akulladdha/riscv-32i-processor/docs/gtkwave.png

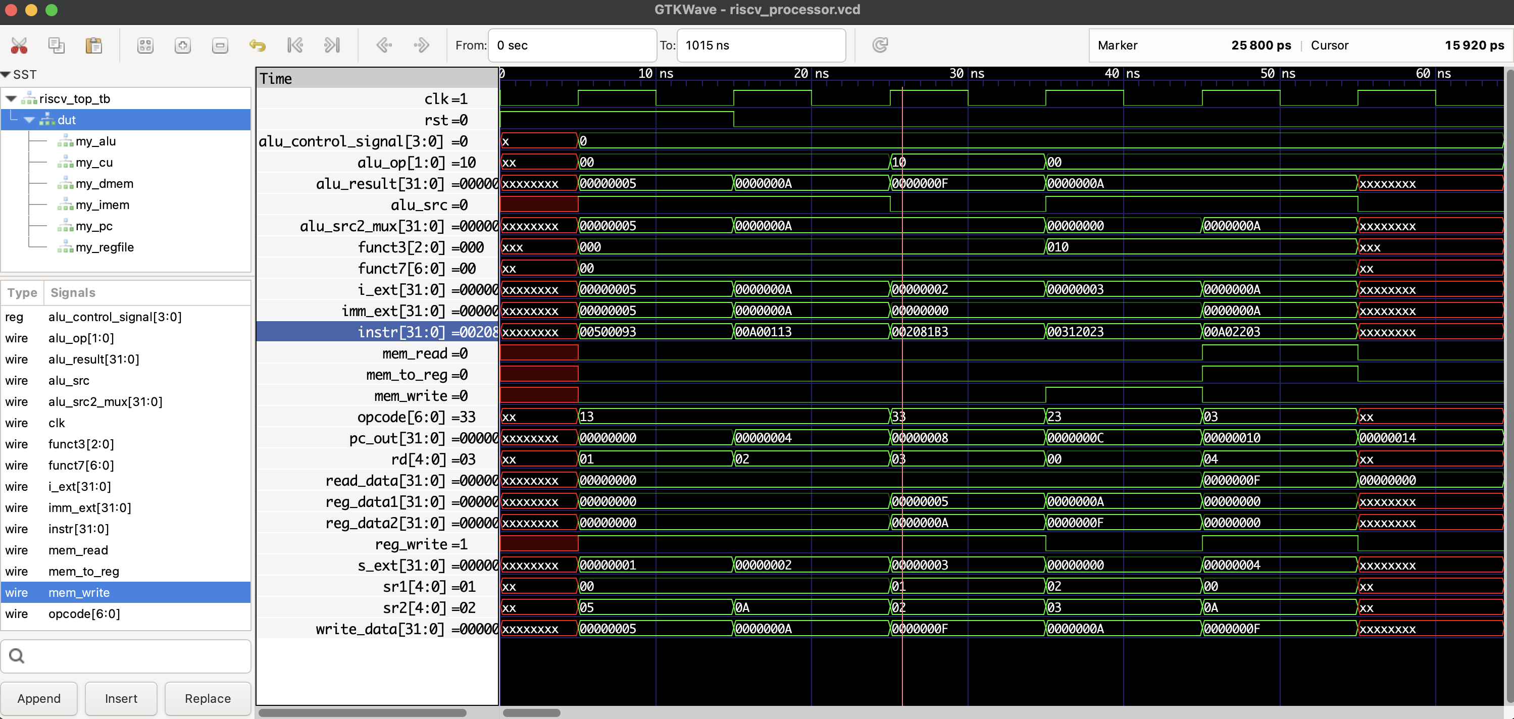
docs/gtkwave.png
