akulladdha/riscv-32i-processor/fpga/basys3.xdc

## Basys 3 constraints for basys3_top.
## Pins taken from Digilent's official Basys-3-Master.xdc, not from memory.

## ---- Clock ----
## create_clock is what makes timing analysis run at all. Without it Vivado
## checks nothing, and a design that "works" may fail after the next rebuild.
set_property -dict { PACKAGE_PIN W5   IOSTANDARD LVCMOS33 } [get_ports clk]
create_clock -add -name sys_clk_pin -period 10.00 -waveform {0 5} [get_ports clk]

## ---- Switches ----
set_property -dict { PACKAGE_PIN V17  IOSTANDARD LVCMOS33 } [get_ports {sw[0]}]
set_property -dict { PACKAGE_PIN V16  IOSTANDARD LVCMOS33 } [get_ports {sw[1]}]
set_property -dict { PACKAGE_PIN W16  IOSTANDARD LVCMOS33 } [get_ports {sw[2]}]
set_property -dict { PACKAGE_PIN W17  IOSTANDARD LVCMOS33 } [get_ports {sw[3]}]
set_property -dict { PACKAGE_PIN W15  IOSTANDARD LVCMOS33 } [get_ports {sw[4]}]
set_property -dict { PACKAGE_PIN V15  IOSTANDARD LVCMOS33 } [get_ports {sw[5]}]
set_property -dict { PACKAGE_PIN W14  IOSTANDARD LVCMOS33 } [get_ports {sw[6]}]
set_property -dict { PACKAGE_PIN W13  IOSTANDARD LVCMOS33 } [get_ports {sw[7]}]
set_property -dict { PACKAGE_PIN V2   IOSTANDARD LVCMOS33 } [get_ports {sw[8]}]
set_property -dict { PACKAGE_PIN T3   IOSTANDARD LVCMOS33 } [get_ports {sw[9]}]
set_property -dict { PACKAGE_PIN T2   IOSTANDARD LVCMOS33 } [get_ports {sw[10]}]
set_property -dict { PACKAGE_PIN R3   IOSTANDARD LVCMOS33 } [get_ports {sw[11]}]
set_property -dict { PACKAGE_PIN W2   IOSTANDARD LVCMOS33 } [get_ports {sw[12]}]
set_property -dict { PACKAGE_PIN U1   IOSTANDARD LVCMOS33 } [get_ports {sw[13]}]
set_property -dict { PACKAGE_PIN T1   IOSTANDARD LVCMOS33 } [get_ports {sw[14]}]
set_property -dict { PACKAGE_PIN R2   IOSTANDARD LVCMOS33 } [get_ports {sw[15]}]

## ---- LEDs ----
set_property -dict { PACKAGE_PIN U16  IOSTANDARD LVCMOS33 } [get_ports {led[0]}]
set_property -dict { PACKAGE_PIN E19  IOSTANDARD LVCMOS33 } [get_ports {led[1]}]
set_property -dict { PACKAGE_PIN U19  IOSTANDARD LVCMOS33 } [get_ports {led[2]}]
set_property -dict { PACKAGE_PIN V19  IOSTANDARD LVCMOS33 } [get_ports {led[3]}]
set_property -dict { PACKAGE_PIN W18  IOSTANDARD LVCMOS33 } [get_ports {led[4]}]
set_property -dict { PACKAGE_PIN U15  IOSTANDARD LVCMOS33 } [get_ports {led[5]}]
set_property -dict { PACKAGE_PIN U14  IOSTANDARD LVCMOS33 } [get_ports {led[6]}]
set_property -dict { PACKAGE_PIN V14  IOSTANDARD LVCMOS33 } [get_ports {led[7]}]
set_property -dict { PACKAGE_PIN V13  IOSTANDARD LVCMOS33 } [get_ports {led[8]}]
set_property -dict { PACKAGE_PIN V3   IOSTANDARD LVCMOS33 } [get_ports {led[9]}]
set_property -dict { PACKAGE_PIN W3   IOSTANDARD LVCMOS33 } [get_ports {led[10]}]
set_property -dict { PACKAGE_PIN U3   IOSTANDARD LVCMOS33 } [get_ports {led[11]}]
set_property -dict { PACKAGE_PIN P3   IOSTANDARD LVCMOS33 } [get_ports {led[12]}]
set_property -dict { PACKAGE_PIN N3   IOSTANDARD LVCMOS33 } [get_ports {led[13]}]
set_property -dict { PACKAGE_PIN P1   IOSTANDARD LVCMOS33 } [get_ports {led[14]}]
set_property -dict { PACKAGE_PIN L1   IOSTANDARD LVCMOS33 } [get_ports {led[15]}]

## ---- Seven-segment display (active low; seg[0] = segment a) ----
set_property -dict { PACKAGE_PIN W7   IOSTANDARD LVCMOS33 } [get_ports {seg[0]}]
set_property -dict { PACKAGE_PIN W6   IOSTANDARD LVCMOS33 } [get_ports {seg[1]}]
set_property -dict { PACKAGE_PIN U8   IOSTANDARD LVCMOS33 } [get_ports {seg[2]}]
set_property -dict { PACKAGE_PIN V8   IOSTANDARD LVCMOS33 } [get_ports {seg[3]}]
set_property -dict { PACKAGE_PIN U5   IOSTANDARD LVCMOS33 } [get_ports {seg[4]}]
set_property -dict { PACKAGE_PIN V5   IOSTANDARD LVCMOS33 } [get_ports {seg[5]}]
set_property -dict { PACKAGE_PIN U7   IOSTANDARD LVCMOS33 } [get_ports {seg[6]}]
set_property -dict { PACKAGE_PIN V7   IOSTANDARD LVCMOS33 } [get_ports dp]

set_property -dict { PACKAGE_PIN U2   IOSTANDARD LVCMOS33 } [get_ports {an[0]}]
set_property -dict { PACKAGE_PIN U4   IOSTANDARD LVCMOS33 } [get_ports {an[1]}]
set_property -dict { PACKAGE_PIN V4   IOSTANDARD LVCMOS33 } [get_ports {an[2]}]
set_property -dict { PACKAGE_PIN W4   IOSTANDARD LVCMOS33 } [get_ports {an[3]}]

## ---- Buttons ----
set_property -dict { PACKAGE_PIN U18  IOSTANDARD LVCMOS33 } [get_ports btnC]
set_property -dict { PACKAGE_PIN T18  IOSTANDARD LVCMOS33 } [get_ports btnU]

## ---- Asynchronous inputs ----
## Buttons and switches have no timing relationship to clk; each is caught by a
## 2-flop synchronizer in the RTL. Tell timing analysis not to time the path
## from the pin into the first flop - there is no meaningful requirement there.
set_false_path -from [get_ports {sw[*] btnC btnU}]

## ---- Configuration (from the Digilent master file) ----
set_property CONFIG_VOLTAGE 3.3 [current_design]
set_property CFGBVS VCCO [current_design]
set_property BITSTREAM.GENERAL.COMPRESS TRUE [current_design]
set_property BITSTREAM.CONFIG.CONFIGRATE 33 [current_design]
set_property CONFIG_MODE SPIx4 [current_design]
