akulladdha/riscv-32i-processor/src/alu.v

`default_nettype none
module alu (
    input  wire [31:0] a,
    input  wire [31:0] b,
    input  wire [3:0] opcode,
    output reg [31:0] result

);
    always @(*) begin
        case (opcode)
            4'b0000: result = a + b; //add
            4'b0001: result = a - b; //sub
            4'b0010: result = a & b; //and
            4'b0011: result = a | b; //or
            
            4'b0100: result = a ^ b; //xor
            4'b0101: result = a << b[4:0]; //sll, shamt masked to 5 bits
            4'b0110: result = a >> b[4:0]; //srl
            4'b0111: result = $signed(a) >>> b[4:0]; //sra
            4'b1000: result = ($signed(a) < $signed(b)) ? 32'd1 : 32'd0; //slt
            4'b1001: result = (a < b) ? 32'd1 : 32'd0; //sltu
            default: result = 32'b0; 
        endcase
    end

endmodule

`default_nettype wire
