akulladdha/riscv-32i-processor/src/pc.v

`default_nettype none
module pc(
    input  wire clk,
    input  wire reset,
    input  wire [31:0] pc_in,
    output reg [31:0] pc_out
);

always @(posedge clk) begin
    if (reset) begin
        pc_out <= 32'b0;
    end else begin
        pc_out <= pc_in;
    end
end
endmodule

`default_nettype wire
