akulladdha/riscv-32i-processor/(commit log)

2026-04-14 added basic 5 stage pipelining functionality
2026-09-09 Add CLAUDE.md: architecture audit, file map, build flow, known issues
    Static audit of the RTL. Records 19 known issues tagged correctness bug /
    FPGA synthesis risk / repo hygiene, each cited to file and line.
    Headline findings:
    - RAW hazard at distance 3 reads a stale register. The register file
    has no write-first bypass (register_file.v:15-16 vs :24-26) and
    forwarding only covers distance 1 and 2. README's claim of handling
    all data hazards is false.
    - control_unit ignores funct3 entirely, so every I-type ALU op runs as
    ADDI, every branch as BEQ (BNE is inverted), and every load/store
    width as word.
    - Neither memory is BRAM-inferrable; riscv_top has no output port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
2026-09-09 CLAUDE.md: recommend native Windows over WSL2 for simulation
    The WSL2-first recommendation was justified on POSIX compatibility, but
    this repo has no Makefile, shell script, or TCL to be compatible with --
    the build is three iverilog/vvp invocations. Native Windows avoids the
    9p /mnt/c bridge to the OneDrive-hosted repo and the WSLg dependency for
    GTKWave.
    Documents the one real friction: PowerShell does not glob-expand for
    native executables (verified), so src/*.v must be expanded via
    Get-ChildItem, or the command run verbatim in Git Bash.
2026-09-09 CLAUDE.md: Part A verified by execution; three bugs reproduced
    Installed Icarus Verilog 12.0 (winget Icarus.Verilog, bundles GTKWave)
    and ran the simulation. Replaces the static-analysis hedging with results.
    Verified:
    - test/top_tb.v PASSES, exit 0. Hand-traced prediction was correct.
    Reproduced, each with a minimal hex program:
    - #1 distance-3 RAW reads a stale register. ADDI x1,x0,5 / NOP / NOP /
    ADD x5,x1,x0 gives x5=0, while the distance-4 control gives x6=5.
    - #2 ANDI x7,x1,3 with x1=5 gives x7=8 (5+3), not 1 (5&3).
    - #3 BNE x1,x2,+8 with 5!=7 does not branch; x3=99. Inverted.
    Rewrote #13: the suite passing is itself the finding. The only
    self-checking test covers one pa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
2026-09-09 Add test harness: RV32I assembler, self-checking runner, PROGRAM parameter
    Writing directed tests by hand-encoding RISC-V is error-prone, so this
    adds tests/asm.pl - a two-pass RV32I assembler with label support,
    validated against seven encodings verified by hand against the spec.
    tests/run_tests.sh assembles every tests/progs/*.s, builds every
    tests/tb/*_tb.v, runs them, and tallies. It also runs the repo's original
    test/top_tb.v so regressions surface immediately.
    instruction_mem and riscv_top gain a PROGRAM parameter defaulting to
    sample_program.hex, so a testbench can select its own program without
    each test needing its own working directory. Backward compatible - the
    original testbenc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
2026-09-09 Implement R-type SLL SLT SLTU XOR SRL SRA
    The ALU had four operations live and six commented out, and the
    ALU-control decoder handled only funct3 000/111/110 - everything else
    fell to a default of ADD. Six R-type instructions therefore performed
    silent additions with plausible-looking results.
    Adds the six ALU cases and five decoder cases. SRA uses an arithmetic
    shift, SLT compares signed and SLTU unsigned; the commented-out draft
    had used an unsigned compare under an SLT label. Shift amounts mask to
    b[4:0], covered by a directed shift-by-33 case expecting a shift of 1.
    tests/progs/rtype.s covers all six plus the masking case.
2026-09-09 Implement I-type SLTI SLTIU XORI ORI ANDI SLLI SRLI SRAI
    control_unit matched opcode 0010011 and hardcoded alu_op=2'b00 with the
    comment 'force add', ignoring funct3 entirely, so all nine I-type ALU
    instructions performed additions.
    Adds alu_op=2'b11 meaning 'I-type ALU' and a funct3 case in the ALU
    control decoder. funct3 000 is always ADDI - there is no SUBI - and
    funct7[5] applies only to SRAI vs SRLI. All eight funct3 values are
    listed so the case infers no latch.
    Shift immediates need no special handling: imm[4:0] already lands in the
    low bits of the sign-extended immediate and the ALU masks to b[4:0].
    Note ORI passed even while broken, since 12|3 and 12+3 are both 15.
2026-09-09 Implement BNE BLT BGE BLTU BGEU branch conditions
    The decoder keyed on opcode 1100011 alone and the EX stage tested only
    ex_zero, so every conditional branch behaved as BEQ. BNE was therefore
    inverted - it branched exactly when it must not.
    Replaces the bare ex_zero test with a funct3-selected comparator using
    casts for BLT/BGE and raw operands for BLTU/BGEU. It reads the
    forwarded operands so a branch can still compare values in flight.
    control_unit is left alone: alu_op=2'b01 still drives a subtract whose
    result is now unused for the branch decision. Removing it would be a
    refactor rather than a fix.
    tests/progs/bcond.s exercises all six types in both directions.
2026-09-09 Implement sub-word loads LB LH LBU LHU
    The load opcode was decoded without funct3, and id_ex_funct3 was dropped
    after EX, so every load returned a full word and the signed/unsigned
    distinction did not exist.
    Adds funct3 to the EX/MEM register and extracts plus extends in the MEM
    stage: the low address bits select the byte or halfword little-endian,
    LB/LH replicate the top bit, LBU/LHU zero-fill, and the default passes
    the word through so LW is unchanged.
    Doing the extension in MEM rather than WB keeps it to one new pipeline
    field and leaves mem_wb_read_data holding the extended value, so the
    existing MEM/WB forwarding path stays correct with no change.
    data_mem is untouched - this is enti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
2026-09-09 Implement byte and halfword stores SB and SH
    data_mem wrote all 32 bits unconditionally and the decoder ignored
    funct3, so SB and SH behaved as SW and destroyed the bytes they should
    have left alone.
    Adds a 4-bit byte_en to data_mem with one enable per lane, and computes
    the enable plus lane-replicated store data in riscv_top. Replicating the
    data across all four lanes means the enable alone decides what lands, so
    the memory needs no shifter. SW takes the default of 4'b1111 and is
    unchanged.
    Also reconnects the new port in test/logic_test_tb.v, which instantiates
    data_mem directly and was left with byte_en floating - its store test
    silently wrote nothing while still printing 'Test Complete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
2026-09-09 Implement JAL
    Opcode 1101111 was not decoded and fell to the empty default, so no link
    register was written and the PC never redirected - control fell straight
    through into the instructions the jump should have skipped.
    The link value rides existing hardware rather than needing a new
    writeback mux: JAL sets alu_a_src to PC and the EX stage forces the ALU
    B operand to 4, so the ALU computes PC+4 and it flows to the register
    file through the normal ALU path with mem_to_reg=0. No new pipeline
    field past EX, and MEM/WB forwarding of a link register works for free.
    The target needs no new adder either - ex_branch_target is already
    id_ex_pc + id_ex_imm_ext. branch_taken and jump_taken merge into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
2026-09-09 Implement JALR with LSB clear
    Opcode 1100111 was not decoded, and no & ~1 existed anywhere in the
    source - the spec-required LSB clear had nothing to clear.
    JALR decodes with jump=1, reusing the entire link and flush path added
    for JAL, plus a new jalr bit selecting rs1+imm over pc+imm for the
    target, with bit 0 forced to zero.
    The forwarded rs1 is split into its own wire because ex_alu_a carries
    the PC for a jump's link value, so the target needs the register
    separately. That split is required by the fix, not a tidy-up.
    Testing the LSB clear needs care: instruction_mem indexes addr>>2 and
    discards addr[1:0], so an odd target still fetches the right word. The
    test jumps to 29 and places a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
2026-09-09 Add directed hazard tests for forwarding, stalls, flush, and x0
    Opcode coverage on a pipelined core says little without hazard coverage.
    Adds five tests targeting control logic rather than the ISA: forwarding
    paths isolated by dependency distance including both-sources contention,
    load-use interlock with ALU and branch consumers, flush depth and
    back-to-back redirects, x0 write discard, and FENCE as an architectural
    NOP. No RTL changed.
    Each test was mutation-checked by deliberately breaking the RTL and
    confirming the right assertion failed: reversing forwarding priority,
    forcing stall to 0, reducing flush depth to 1, and allowing writes to
    x0. All four were caught and reverted; suite retur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
2026-09-09 Delete dead pipeline registers and the unused ALU zero path
    Seven signals were written every cycle and read by nothing, about 130
    flops. Found by reference-counting every declaration in the module.
    Two independent causes: a pc_plus4 chain three stages long that never
    gained a consumer, since JAL routes its link value through the ALU
    instead; and leftovers from a design that resolved branches in MEM
    before resolution moved to EX. ex_zero is the ALU's zero output, which
    the funct3 branch comparator replaced - it was left driving a dead
    register.
    19 lines, all deletions, no logic touched. alu.v keeps its zero port,
    left unconnected here, because test/alu_tb.v instantiates the ALU with
    that co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
2026-09-09 Add FPGA readiness roadmap for picking this up later
    Six phases from proving the Vivado toolchain with a blinking LED through
    on-board bring-up with an ILA, with the learning goal named for each.
    Written self-contained: records current branch state, undo tags, test
    counts, and toolchain paths so the work can resume cold.
    Leads with the blocking fact - riscv_top has no output ports, so the
    correct result of synthesizing it today is an empty bitstream - and
    flags the Phase 1 predictions (neither memory infers BRAM, and the
    register file's reset loop forces flip-flops rather than LUTRAM) as
    hypotheses to check against real synthesis reports rather than as
    facts.
2026-09-09 Rewrite README for the current state of the processor
    The landing page still described 8 instructions and claimed the design
    handled all data hazards correctly - a claim that was false when written
    (the distance-3 RAW bug) and would have become accidentally true after
    the fixes.
    Now lists all 38 implemented instructions, names the two that are not
    and why, describes the write-first register file and the funct3 branch
    comparator, and documents the mutation testing.
    Adds a Status section stating plainly that this is not FPGA-ready, with
    the three specific reasons, and links to the coverage, fixes, and
    roadmap documents so a visitor can find the substantive work.
2026-11-12 Rewrite CLAUDE.md for the current RTL and session goals
2026-11-12 Rewrite immediate generator as a case on named opcodes
2026-11-12 Stall on load-use only for source registers the instruction reads
    control_unit now reports whether rs1 and rs2 are real for the decoded
    format, so immediate bits in those positions no longer cause false
    stalls. The new stallprec test counts stall cycles: 3 before, 1 after.
2026-11-12 Halt on ECALL, EBREAK and illegal opcodes
    The halt is taken when the instruction reaches EX, so an ECALL fetched
    in the shadow of a taken branch cannot stop the core. The front end
    freezes while older instructions drain, and new sticky halted and
    error outputs report the result. Bubbles are now the canonical NOP,
    since the all-zero word is an illegal instruction. The assembler gains
    .word for writing raw words.
2026-11-12 Add a clock enable and debug read ports to the core
    The core advances only on cycles where ce is high, which lets a board
    wrapper slow or single-step it without a divided clock. Reset still
    works while paused. A third register-file read port and the PC are
    exposed for display. The new cegate test runs a gated and an ungated
    core side by side and requires identical final state.
2026-11-12 Add a Basys 3 board wrapper, constraints and build script
    The wrapper drives the CPU with a run or single-step clock enable,
    conditions the buttons and switches, and shows any register or the PC
    on the seven-segment display and LEDs. Pins come from Digilent's
    master constraints file. A board-level testbench presses a bouncing
    button and checks the display, and run_tests.sh now runs it. The
    Vivado build script has not been run yet.
